google/prudaq/README.md

## Documentation is on the [Wiki](https://github.com/google/prudaq/wiki)

*This is not an official Google product.*
