google/prudaq/eagle/PRUDAQ-5.0-layout.png

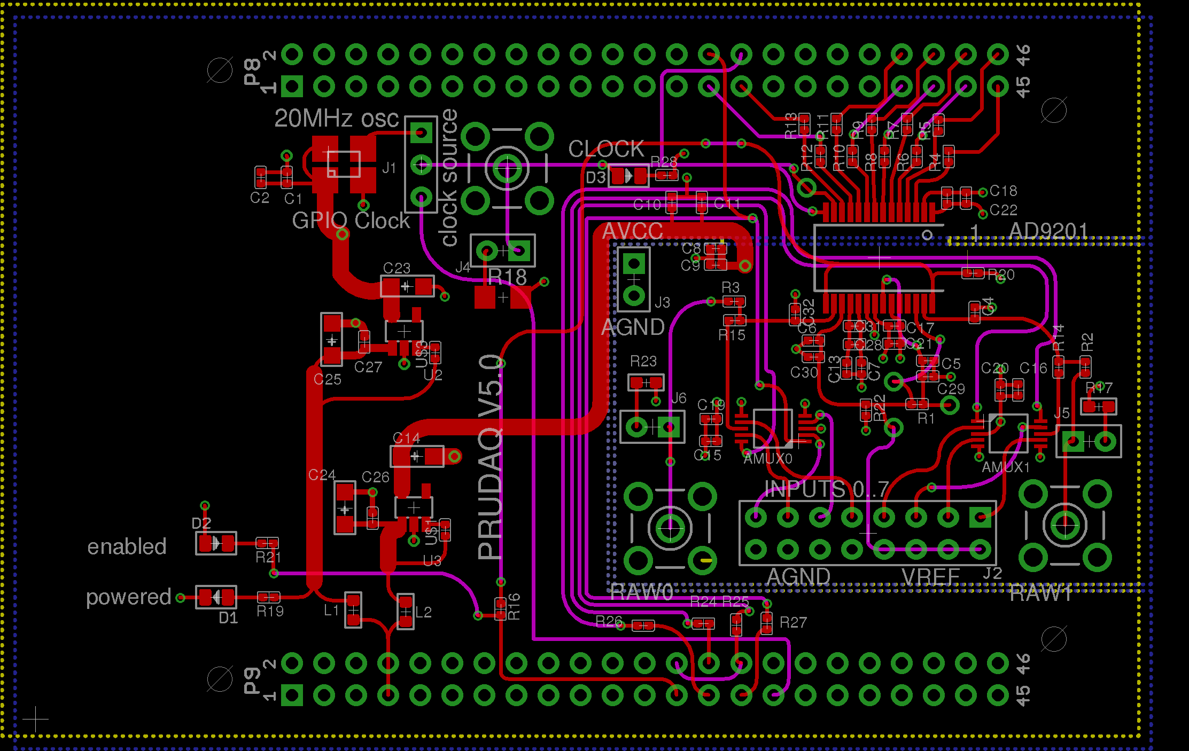
eagle/PRUDAQ-5.0-layout.png
