google/prudaq/eagle/PRUDAQ-5.0-schematic.png

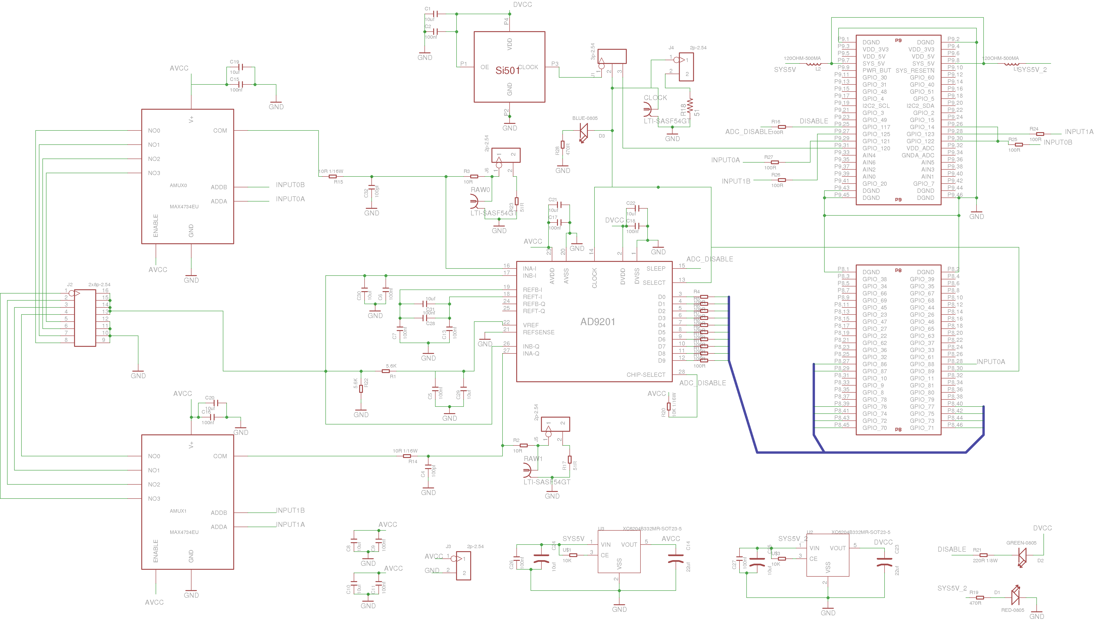
eagle/PRUDAQ-5.0-schematic.png
