google/prudaq/eagle/daq-beaglebone.brd

## EAGLE design eagle/daq-beaglebone.brd (2016-01-04)

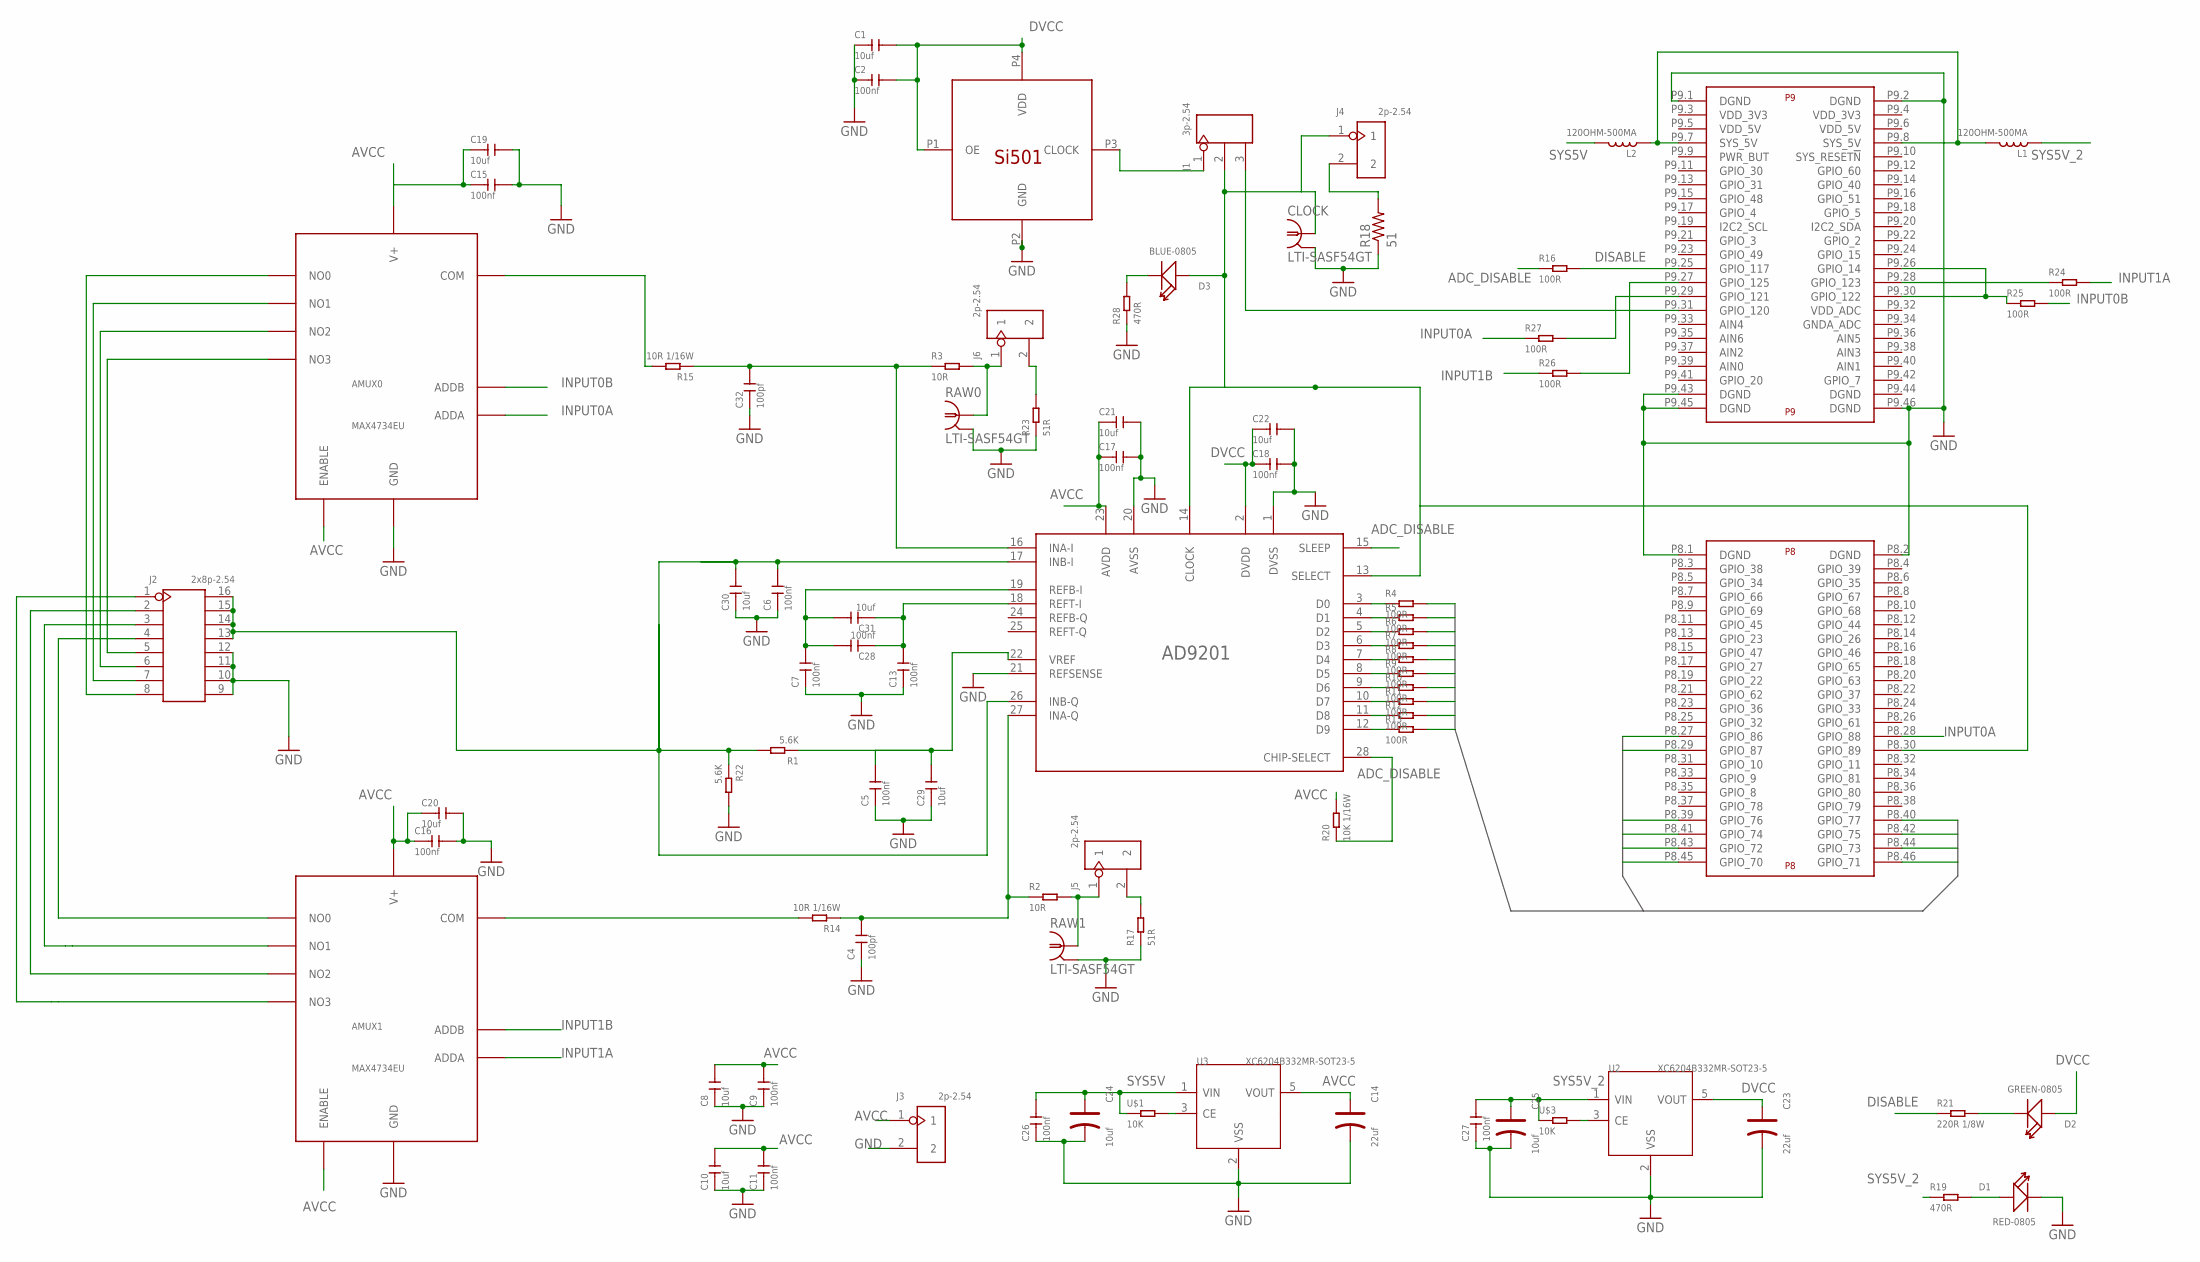
[picture p3: schematic daq-beaglebone.sch]

Parts:
AD9201: AD9201; SSOP28
AMUX0, AMUX1: MAX4734EU; UMAX10
C1, C8, C10, C19, C20, C21, C22, C29, C30, C31: 10uf; C0402
C2, C5, C6, C7, C9, C11, C13, C15, C16, C17, C18, C26, C27, C28: 100nf; C0402
C4, C32: 100pf; C0402
C14, C23: 22uf; AVX-A
C24, C25: 10uf; AVX-A
CLOCK: LTI-SASF54GT
D1: RED-0805; LED-0805
D2: GREEN-0805; LED-0805
D3: BLUE-0805; LED-0805
J1: 3p-2.54; H3-2.54
J2: 2x8p-2.54; H2X8-2.54
J3, J4, J5, J6: 2p-2.54; H2-2.54
L1, L2: 120OHM-500MA; L0603
R1, R22: 5.6K; R0402
R2, R3: 10R; R0402
R4, R5, R6, R7, R8, R9, R10, R11, R12, R13, R16, R24, R25, R26, R27: 100R; R0402
R14, R15: 10R 1/16W; R0402
R17, R23: 51R; R0603
R18: 51; R1206
R19, R28: 470R; R0402
R20: 10K 1/16W; R0402
R21: 220R 1/8W; R0402
RAW0, RAW1: LTI-SASF54GT
U2, U3: XC6204B332MR-SOT23-5; SOT-23-5
U$1, U$3: 10K; R0402
U$2: BEAGLE_BONE_BLACK_CAPE
U$4: SI501; 2X2.5DFN

Connections:
ADC_DISABLE: AD9201.15 (SLEEP), AD9201.28 (CHIP-SELECT), R16.1, R20.1
AVCC: AD9201.23 (AVDD), AMUX0.P$5 (ENABLE), AMUX0.P$6 (V+), AMUX1.P$5 (ENABLE), AMUX1.P$6 (V+), C8.2, C9.2, C10.2, C11.2, C14.+, C15.1, C16.1, C17.1, C19.1, C20.1, C21.1, J3.1, R20.2, U3.5 (VOUT)
CLOCK: AD9201.13 (SELECT), AD9201.14 (CLOCK), CLOCK.1, D3.+, J1.2, J4.1, U$2.P8.30 (GPIO_89)
D0: R4.2, U$2.P8.45 (GPIO_70)
D1: R5.2, U$2.P8.46 (GPIO_71)
D2: R6.2, U$2.P8.43 (GPIO_72)
D3: R7.2, U$2.P8.44 (GPIO_73)
D4: R8.2, U$2.P8.41 (GPIO_74)
D5: R9.2, U$2.P8.42 (GPIO_75)
D6: R10.2, U$2.P8.39 (GPIO_76)
D7: R11.2, U$2.P8.40 (GPIO_77)
D8: R12.2, U$2.P8.27 (GPIO_86)
D9: R13.2, U$2.P8.29 (GPIO_87)
DISABLE: R16.2, R21.1, U$2.P9.25 (GPIO_117)
DVCC: AD9201.2 (DVDD), C1.2, C2.2, C18.1, C22.1, C23.+, D2.+, U2.5 (VOUT), U$4.P1 (OE), U$4.P4 (VDD)
GND: AD9201.1 (DVSS), AD9201.20 (AVSS), AD9201.21 (REFSENSE), AMUX0.P$3 (GND), AMUX1.P$3 (GND), C1.1, C2.1, C4.1, C5.1, C6.1, C7.1, C8.1, C9.1, C10.1, C11.1, C13.1, C14.-, C15.2, C16.2, C17.2, C18.2, C19.2, C20.2, C21.2, C22.2, C23.-, C24.-, C25.-, C26.1, C27.1, C29.1, C30.1, C32.1, CLOCK.2, CLOCK.3 (2), CLOCK.4 (2), CLOCK.5 (2), D1.-, J2.9, J2.10, J2.11, J2.12, J3.2, R17.1, R18.1, R22.2, R23.1, R28.1, RAW0.2, RAW0.3 (2), RAW0.4 (2), RAW0.5 (2), RAW1.2, RAW1.3 (2), RAW1.4 (2), RAW1.5 (2), U2.2 (VSS), U3.2 (VSS), U$2.P8.1 (DGND), U$2.P8.2 (DGND), U$2.P9.1 (DGND), U$2.P9.2 (DGND), U$2.P9.43 (DGND), U$2.P9.45 (DGND), U$2.P9.46 (DGND), U$4.P2 (GND)
INPUT0A: AMUX0.P$1 (ADDA), R27.1, U$2.P8.28 (GPIO_88)
INPUT0B: AMUX0.P$10 (ADDB), R25.2
INPUT1A: AMUX1.P$1 (ADDA), R24.2
INPUT1B: AMUX1.P$10 (ADDB), R26.1
unnamed: AD9201.3 (D0), R4.1
unnamed: AD9201.4 (D1), R5.1
unnamed: AMUX0.P$2 (NO0), J2.8
unnamed: AD9201.17 (INB-I), AD9201.26 (INB-Q), C6.2, C30.2, J2.13, J2.14, J2.15, J2.16, R1.2, R22.1
unnamed: AD9201.22 (VREF), C5.2, C29.2, R1.1
unnamed: AD9201.18 (REFT-I), C13.2, C28.1, C31.1
unnamed: AD9201.19 (REFB-I), C7.2, C28.2, C31.2
unnamed: AMUX0.P$9 (NO1), J2.7
unnamed: R25.1, U$2.P9.26 (GPIO_14), U$2.P9.30 (GPIO_122)
unnamed: AMUX1.P$8 (COM), R14.2
unnamed: AD9201.16 (INA-I), C32.2, R3.1, R15.1
unnamed: AD9201.5 (D2), R6.1
unnamed: AD9201.6 (D3), R7.1
unnamed: AD9201.7 (D4), R8.1
unnamed: AD9201.8 (D5), R9.1
unnamed: AD9201.9 (D6), R10.1
unnamed: AD9201.10 (D7), R11.1
unnamed: AD9201.11 (D8), R12.1
unnamed: AD9201.12 (D9), R13.1
unnamed: J1.1, U$4.P3 (CLOCK)
unnamed: J1.3, U$2.P9.31 (GPIO_120)
unnamed: AMUX0.P$8 (COM), R15.2
unnamed: AD9201.27 (INA-Q), C4.2, R2.1, R14.1
unnamed: R27.2, U$2.P9.29 (GPIO_121)
unnamed: AMUX0.P$4 (NO2), J2.6
unnamed: AMUX0.P$7 (NO3), J2.5
unnamed: D1.+, R19.2
unnamed: J5.1, R2.2, RAW1.1
unnamed: AMUX1.P$4 (NO2), J2.2
unnamed: D3.-, R28.2
unnamed: D2.-, R21.2
unnamed: J6.1, R3.2, RAW0.1
unnamed: J4.2, R18.2
unnamed: U2.3 (CE), U$3.2
unnamed: U3.3 (CE), U$1.2
unnamed: R24.1, U$2.P9.28 (GPIO_123)
unnamed: R26.2, U$2.P9.27 (GPIO_125)
unnamed: J5.2, R17.2
unnamed: J6.2, R23.2
unnamed: AMUX1.P$2 (NO0), J2.4
unnamed: AMUX1.P$9 (NO1), J2.3
unnamed: AMUX1.P$7 (NO3), J2.1
OTHERSYS5V: L1.2, L2.1, U$2.P9.7 (SYS_5V), U$2.P9.8 (SYS_5V)
SYS5V: C24.+, C26.2, L2.2, U3.1 (VIN), U$1.1
SYS5V_2: C25.+, C27.2, L1.1, R19.1, U2.1 (VIN), U$3.1

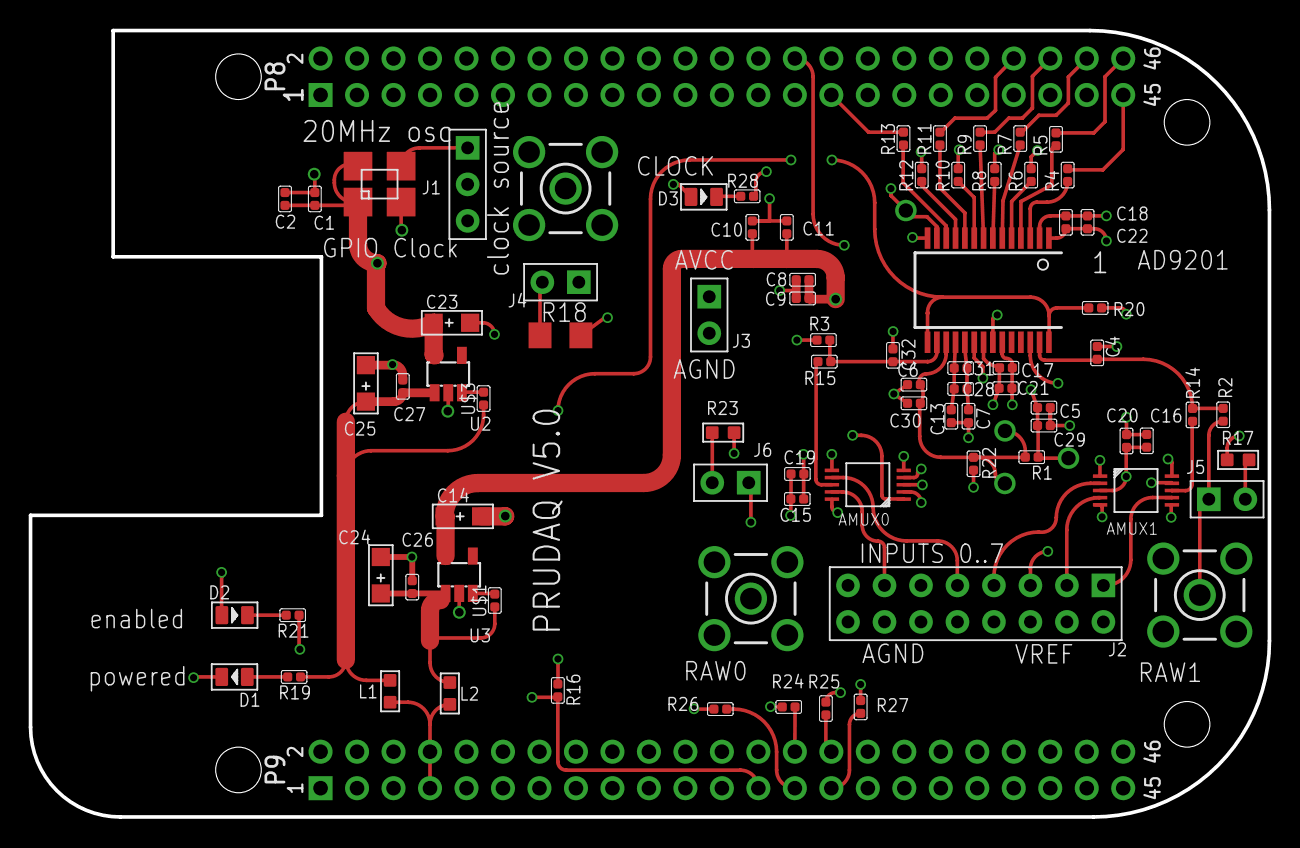
[picture p4: board daq-beaglebone.brd from above]

Board: 4 copper layers, 86.2 x 54.8 mm, 81 parts (0 on the bottom side), 65 nets.
