google/prudaq/(threads)

Thread 27 (2016-07-21):

Opensource

rtrevorclark, 2016-07-21:
Why was closed source software used to make the open source hardware. i.e. why not use KiCad instead of eagle?

credentiality, 2016-07-21:
I did try.  For a project a few years back I used geda/gschem.  This time I tried 3 or 4 of the more popular Free solutions, and couldn't make them work in a reasonable time frame, so I fell back to Eagle.

rtrevorclark, 2016-07-25:
Hey I'm glad to hear you tried. Keep up the good work!

Closed 2016-07-21.

Thread 29 (2016-08-19):

documentation fix

mattvenn, 2016-08-19:
Hi, great work - very very useful documentation. I'm working on adapting prudaq code for a similar project.
I think this line:
cape_disable=capemgr.disable_partno=BB-BONELT-HDMI,BB-BONELT-HDMI

should be

cape_disable=capemgr.disable_partno=BB-BONELT-HDMI,BB-BONELT-HDMIN

credentiality, 2016-08-20:
Right you are!  Fixed.

mattvenn, 2016-08-20:
It's off topic but I was wondering if you could explain how the sample code
enables the pins. I use the dto but then i also need to export the pin
manually to allow the prus to control the pins. I can't see how this would
happen in the prudaq code.

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

credentiality, 2016-08-20:
http://credentiality2.blogspot.com/2015/09/beaglebone-pru-gpio-example.html?m=1

sent from my android

mattvenn, 2016-08-20:
thanks, nice website.
I figured out my problem was either a buggy install or buggy tools. A dts
will only only load once and then any changes need a reboot.

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

--
Matthew Venn
web mattvenn.net twitter @matthewvenn <https://twitter.com/matthewvenn>

Closed 2016-08-20.

Thread 31 (2019-11-15):

Quickstart-Guide not uptodate

rocketBeagle, 2019-11-15:
The newest beagleLogic-image from  https://beaglelogic.readthedocs.io/en/latest/beaglelogic_system_image.html   (Released on 2017-07-13)
comes with the kernel version 4.9 , but the quickstart "Option 1: Using the BeagleLogic system image" describes the sampling with a 4.8 kernel version i think.

In the image with the 4.9 kernel version some folders/paths have different names now...
So replacing pru1 firmware (step 6) and setting up the pwm-signal for the clock (step 7, end of setup-script) doesnt work like described in the quickstart with the newest beaglelogic image...

credentiality, 2019-11-15:
Indeed.  That stuff has changed a lot across releases and I always had
trouble finding good docs on the changes.  Worse, the distros would ship
incompatible versions of tools that would fail silently.  If you can get it
to work with the new stuff, it'll be good to have it on the wiki.  But if
you just want it to work, you're best off using the older distro linked in
the quickstart.

>

rocketBeagle, 2019-11-18:
Thanks for the answer! I think i will try the older one first...

rocketBeagle, 2019-11-19:
Can I start and stop the sampling by pull P9_25 low/high?
Is that the right way to do it?

credentiality, 2019-11-19:
That is indeed the enable pin for the adc.  It might be what you want
depending whether you want to start and stop sampling at the adc or by the
firmware, and whether the firmware you're using is generating a clock
signal or being driven by it.

rocketBeagle, 2019-11-19:
Actually the firmware should stop sampling. So it should start and stop sampling from within my c++ programm. Not shure whether there is a file somewhere I can echo to? ( maybe /sys/devices/virtual/misc/beaglelogic/state ? )
Thanks a lot for your advice!

credentiality, 2019-11-19:
Been a while since I played with beaglelogic, but yeah, looks like it maybe
opening and closing /dev/beaglelogic affects capture, and maybe the
triggerflags setting.

rocketBeagle, 2019-11-19:
Yes, you are right! On the beagleLogic-github page there is a description of the sysfs-attributes (https://github.com/abhishek-kakkar/BeagleLogic/wiki/sysfs-attributes-Reference) and there it says at 'triggerflags':
"_If data is not removed fast enough as it arrieved, it may be overwritten. Kernel logs can reveal where the overrun had occurred._"
So I randomly tryed the _dmesg_-command and the nice thing is: it does not only inform you about an overun: every time you read from /dev/beaglelogic
(_hexdump -d /dev/beaglelogic |head , or dd if=/dev/beaglelogic of=myfile.bin bs=1M count=64_) , dmesg says _"capture started with ..."_ and when the read is finished dmesg says _"capture session ended"_.
So to stop sampling pulling P9_25 high is not necessary. You can simply start and stop reading from /dev/beaglelogic.
Thank you for the advice!

(Btw, the /sys/devices/virtual/misc/beaglelogic/state attribute is for testing purposes only)

rocketBeagle, 2020-01-19:
This project is so cool =D

PRU1 waits for a rising or falling edge of the ADC-clock , than samples the ADC output pins. (The pru1 assembler code is also very interesting)
So if using the onboard 10 MHz clock for running the ADC on PRUDAQ board:
Am I correct in assuming that the beagleLogic samplerate-parameter is actually without function for the PRUDAQ project? Didn't find information on that...

credentiality, 2020-01-22:
Yes, I believe that's correct.

Thread 32 (2021-07-05):

Couldn't enable the prudaq-00A0.dtbo device overlay

alisadra, 2021-07-05:
hi
after make and make install(run true). i run sudo ./setupT but i have this error:

 ./setup.sh: line 43: echo: write error: File exists
Couldn't enable the prudaq-00A0.dtbo device overlay. (If the error was 'File exists', then the overlay was already enabled.)

i check /lib/firmware and   prudaq-00A0.dtbo exist in this location.

in uEnv.txt:
i first comment enable_uboot_overlays=1(if was uncomment slots not exist in bone_capemgr)

any one can help?

credentiality, 2021-07-05:
Device overlays were always a nightmare for us, sorry.  The distros seemed
to ship with broken tools and I couldn't make sense of documentation.  The
only thing that worked for me was using the original system image from when
prudaq released.

sent from my phone

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
