google/prudaq/(commit log)

2016-01-04 Init copy schematics/layout, analog capture code, bom, readme, license
    [daq-beaglebone.brd, daq-beaglebone.sch]
2016-01-28 figures for board docs
2016-01-28 Describes two board mods
    Differential input support and control of channel readout
2016-01-28 Theory of operation for the board
2016-01-29 Create InputOutput.md
    Describes GPIO pin assignments and how the PRUs talk to the ADC.
2016-02-25 Simplified schematic shows how the 8 inputs work
2016-03-02 Code cleanup, commenting, and error checking
    [prudaq_capture.c, shared_header.h]
2016-03-26 Paste in sample output
2016-05-14 Schematic and layout PNGs for those without eagle
    File... Export... Image. Then 300dpi for the schematic and 600dpi for the layout.
2016-06-11 minor fixes to selftest
    [selftest.c]
2016-06-13 Make errors more helpful
    [selftest.c]
2016-08-31 Fix data corruption when buf rolls over. h/t mattvenn.
    [prudaq_capture.c]
